rishith-c/Prometheus/pcb/board-3d-top.png

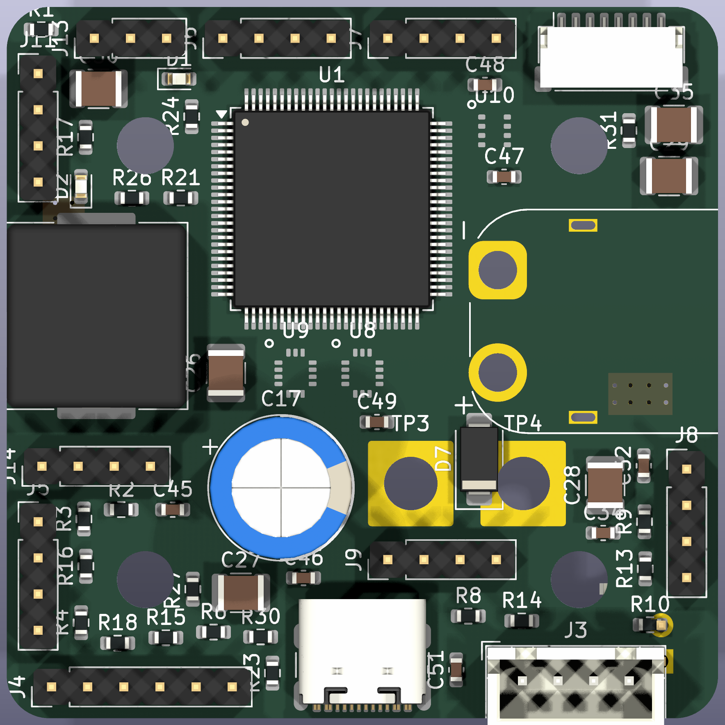
pcb/board-3d-top.png
