rishith-c/Prometheus/pcb/board-3d-angle.png

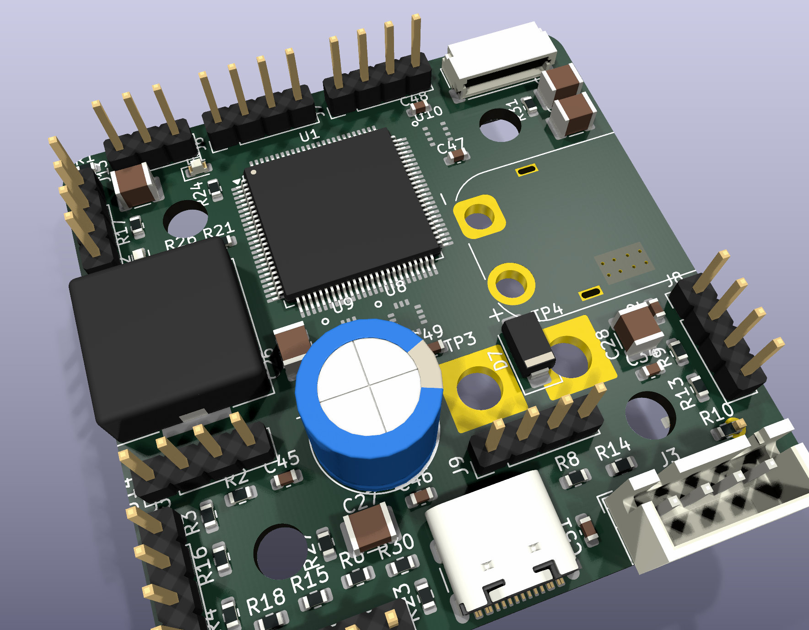
pcb/board-3d-angle.png
