rishith-c/Prometheus/pcb/board-3d-bottom.png

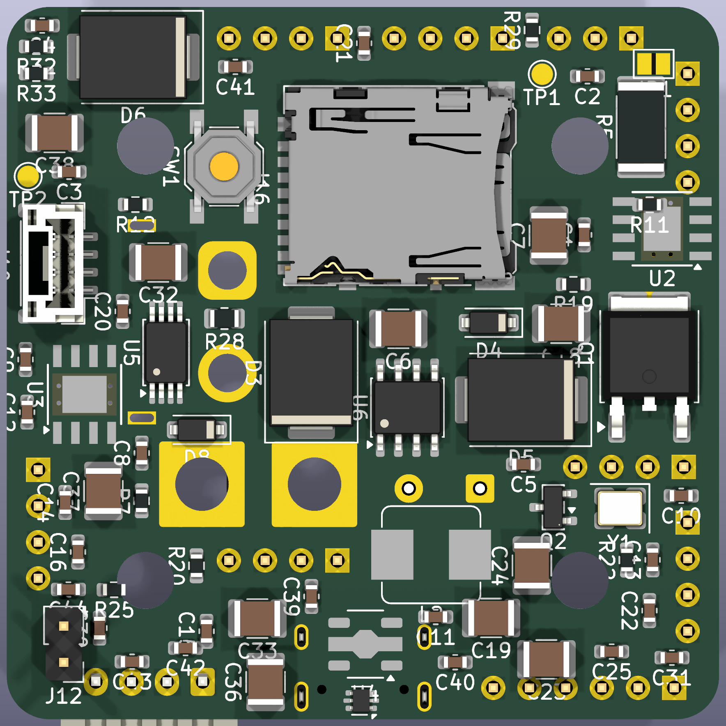
pcb/board-3d-bottom.png
