rishith-c/Prometheus/pcb/baro.kicad_sch

## KiCad design pcb/baro.kicad_sch (2026-07-14)

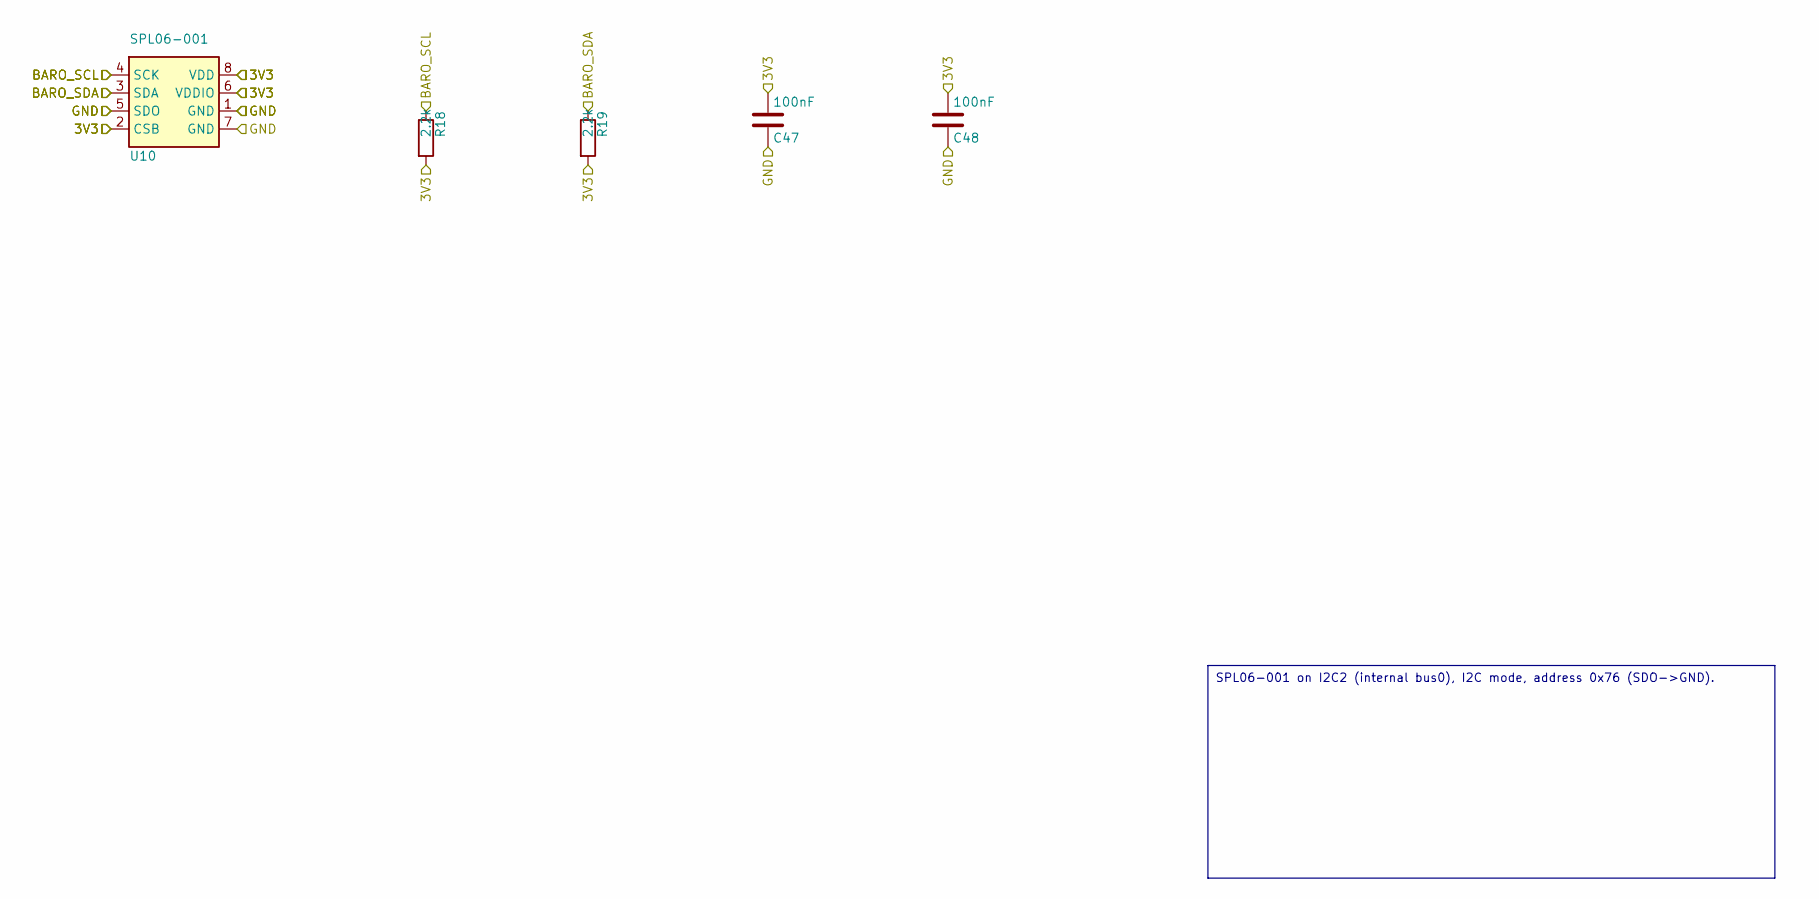
[picture p4: schematic baro.kicad_sch]

Parts:
C47, C48: 100nF; C_0603_1608Metric
R18, R19: 2.2k; R_0603_1608Metric
U10: SPL06-001; SPL06-001_LGA-8_2.0x2.5mm; LCSC C2684428

Connections:
3V3: C47.1, C48.1, R18.2, R19.2, U10.2 (CSB), U10.6 (VDDIO), U10.8 (VDD)
BARO_SCL: R18.1, U10.4 (SCK)
BARO_SDA: R19.1, U10.3 (SDA)
GND: C47.2, C48.2, U10.1 (GND), U10.5 (SDO), U10.7 (GND)

Notes on the sheet:
SPL06-001 on I2C2 (internal bus0), I2C mode, address 0x76 (SDO->GND).
