rishith-c/Prometheus/pcb/bucks_ldo.kicad_sch

## KiCad design pcb/bucks_ldo.kicad_sch (2026-07-14)

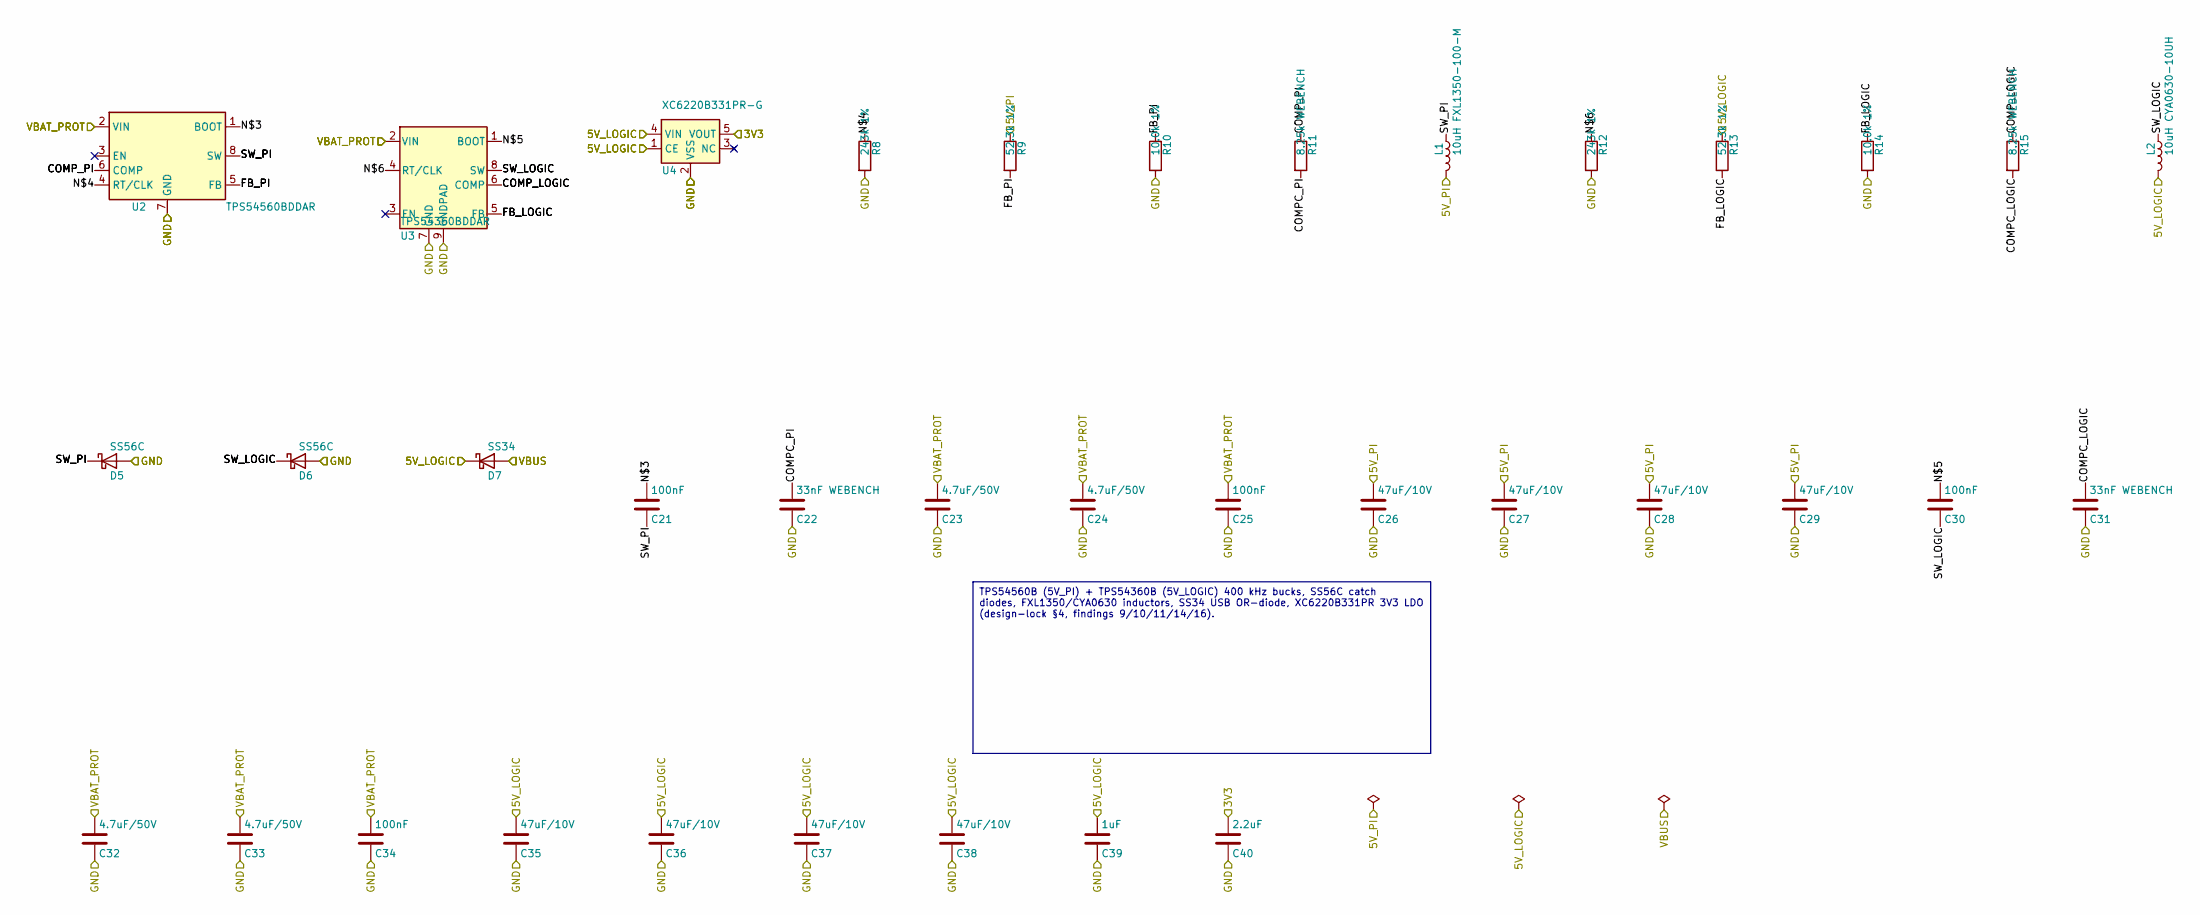
[picture p5: schematic bucks_ldo.kicad_sch]

Parts:
C21, C25, C30, C34: 100nF; C_0603_1608Metric
C22, C31: 33nF WEBENCH; C_0603_1608Metric
C23, C24, C32, C33: 4.7uF/50V; C_1210_3225Metric
C26, C27, C28, C29, C35, C36, C37, C38: 47uF/10V; C_1210_3225Metric
C39: 1uF; C_0603_1608Metric
C40: 2.2uF; C_0603_1608Metric
D5, D6: SS56C; D_SMC; LCSC C24138
D7: SS34; D_SMA; LCSC C8678
L1: 10uH FXL1350-100-M; L_Changjiang_FXL1350; LCSC C526017
L2: 10uH CYA0630-10UH; L_Bourns_SRP7028A_7.3x6.6mm; LCSC C5189958
R8, R12: 243k 1%; R_0603_1608Metric
R9, R13: 52.3k 1%; R_0603_1608Metric
R10, R14: 10.0k 1%; R_0603_1608Metric; LCSC C25804
R11, R15: 8.25k WEBENCH; R_0603_1608Metric
U2: TPS54560BDDAR; TI_SO-PowerPAD-8_ThermalVias; LCSC C1850354
U3: TPS54360BDDAR; TI_SO-PowerPAD-8_ThermalVias; LCSC C524806
U4: XC6220B331PR-G; SOT-89-5; LCSC C3013658

Connections:
3V3: C40.1, U4.5 (VOUT)
5V_LOGIC: C35.1, C36.1, C37.1, C38.1, C39.1, D7.1 (K), L2.2, R13.1, U4.1 (CE), U4.4 (VIN)
5V_PI: C26.1, C27.1, C28.1, C29.1, L1.2, R9.1
COMPC_LOGIC: C31.1, R15.2
COMPC_PI: C22.1, R11.2
COMP_LOGIC: R15.1, U3.6 (COMP)
COMP_PI: R11.1, U2.6 (COMP)
FB_LOGIC: R13.2, R14.1, U3.5 (FB)
FB_PI: R9.2, R10.1, U2.5 (FB)
GND: C22.2, C23.2, C24.2, C25.2, C26.2, C27.2, C28.2, C29.2, C31.2, C32.2, C33.2, C34.2, C35.2, C36.2, C37.2, C38.2, C39.2, C40.2, D5.2 (A), D6.2 (A), R8.2, R10.2, R12.2, R14.2, U2.7 (GND), U2.9 (GND), U3.7 (GND), U3.9 (GNDPAD), U4.2 (VSS)
unnamed: C21.1, U2.1 (BOOT)
unnamed: R8.1, U2.4 (RT/CLK)
unnamed: C30.1, U3.1 (BOOT)
unnamed: R12.1, U3.4 (RT/CLK)
SW_LOGIC: C30.2, D6.1 (K), L2.1, U3.8 (SW)
SW_PI: C21.2, D5.1 (K), L1.1, U2.8 (SW)
VBAT_PROT: C23.1, C24.1, C25.1, C32.1, C33.1, C34.1, U2.2 (VIN), U3.2 (VIN)
VBUS: D7.2 (A)

Notes on the sheet:
TPS54560B (5V_PI) + TPS54360B (5V_LOGIC) 400 kHz bucks, SS56C catch diodes, FXL1350/CYA0630 inductors, SS34 USB OR-diode, XC6220B331PR 3V3 LDO (design-lock §4, findings 9/10/11/14/16).
