rishith-c/Prometheus/pcb/can.kicad_sch

## KiCad design pcb/can.kicad_sch (2026-07-14)

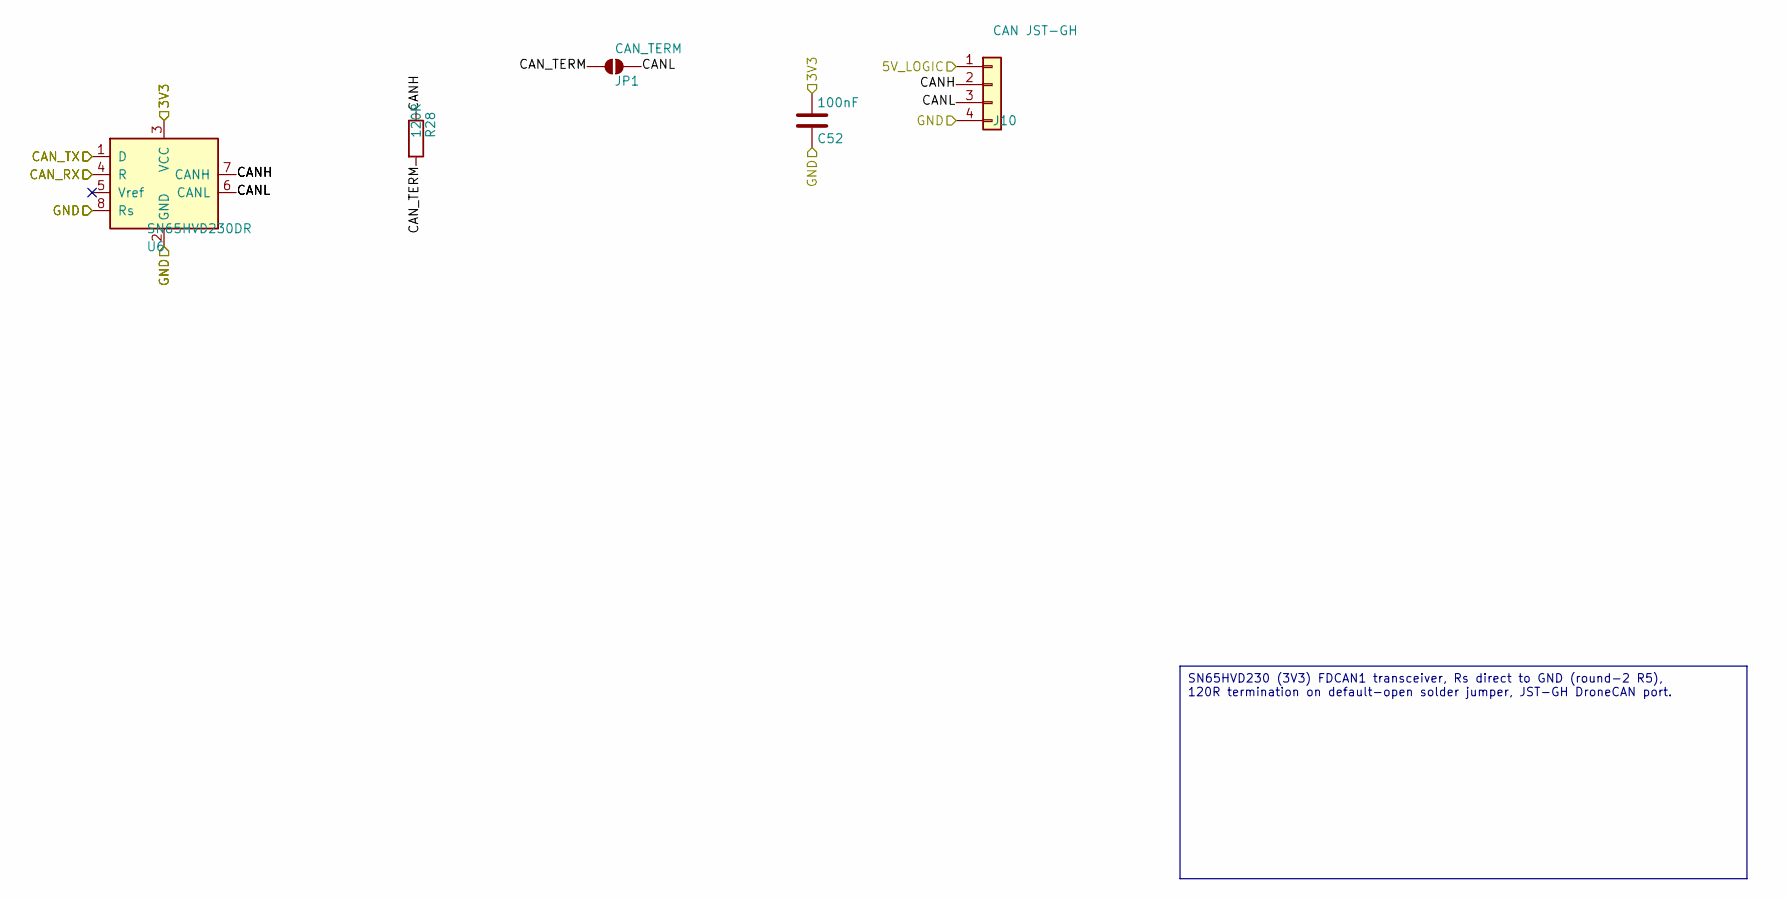
[picture p6: schematic can.kicad_sch]

Parts:
C52: 100nF; C_0603_1608Metric
J10: CAN JST-GH; JST_GH_BM04B-GHS-TBT_1x04-1MP_P1.25mm_Vertical
JP1: CAN_TERM; SolderJumper-2_P1.3mm_Open_Pad1.0x1.5mm
R28: 120R; R_0805_2012Metric
U6: SN65HVD230DR; SOIC-8_3.9x4.9mm_P1.27mm; LCSC C12084

Connections:
3V3: C52.1, U6.3 (VCC)
5V_LOGIC: J10.1
CANH: J10.2, R28.1, U6.7 (CANH)
CANL: J10.3, JP1.2 (B), U6.6 (CANL)
CAN_RX: U6.4 (R)
CAN_TERM: JP1.1 (A), R28.2
CAN_TX: U6.1 (D)
GND: C52.2, J10.4, U6.2 (GND), U6.8 (Rs)

Notes on the sheet:
SN65HVD230 (3V3) FDCAN1 transceiver, Rs direct to GND (round-2 R5), 120R termination on default-open solder jumper, JST-GH DroneCAN port.
