rishith-c/Prometheus/pcb/connectors.kicad_sch

## KiCad design pcb/connectors.kicad_sch (2026-07-14)

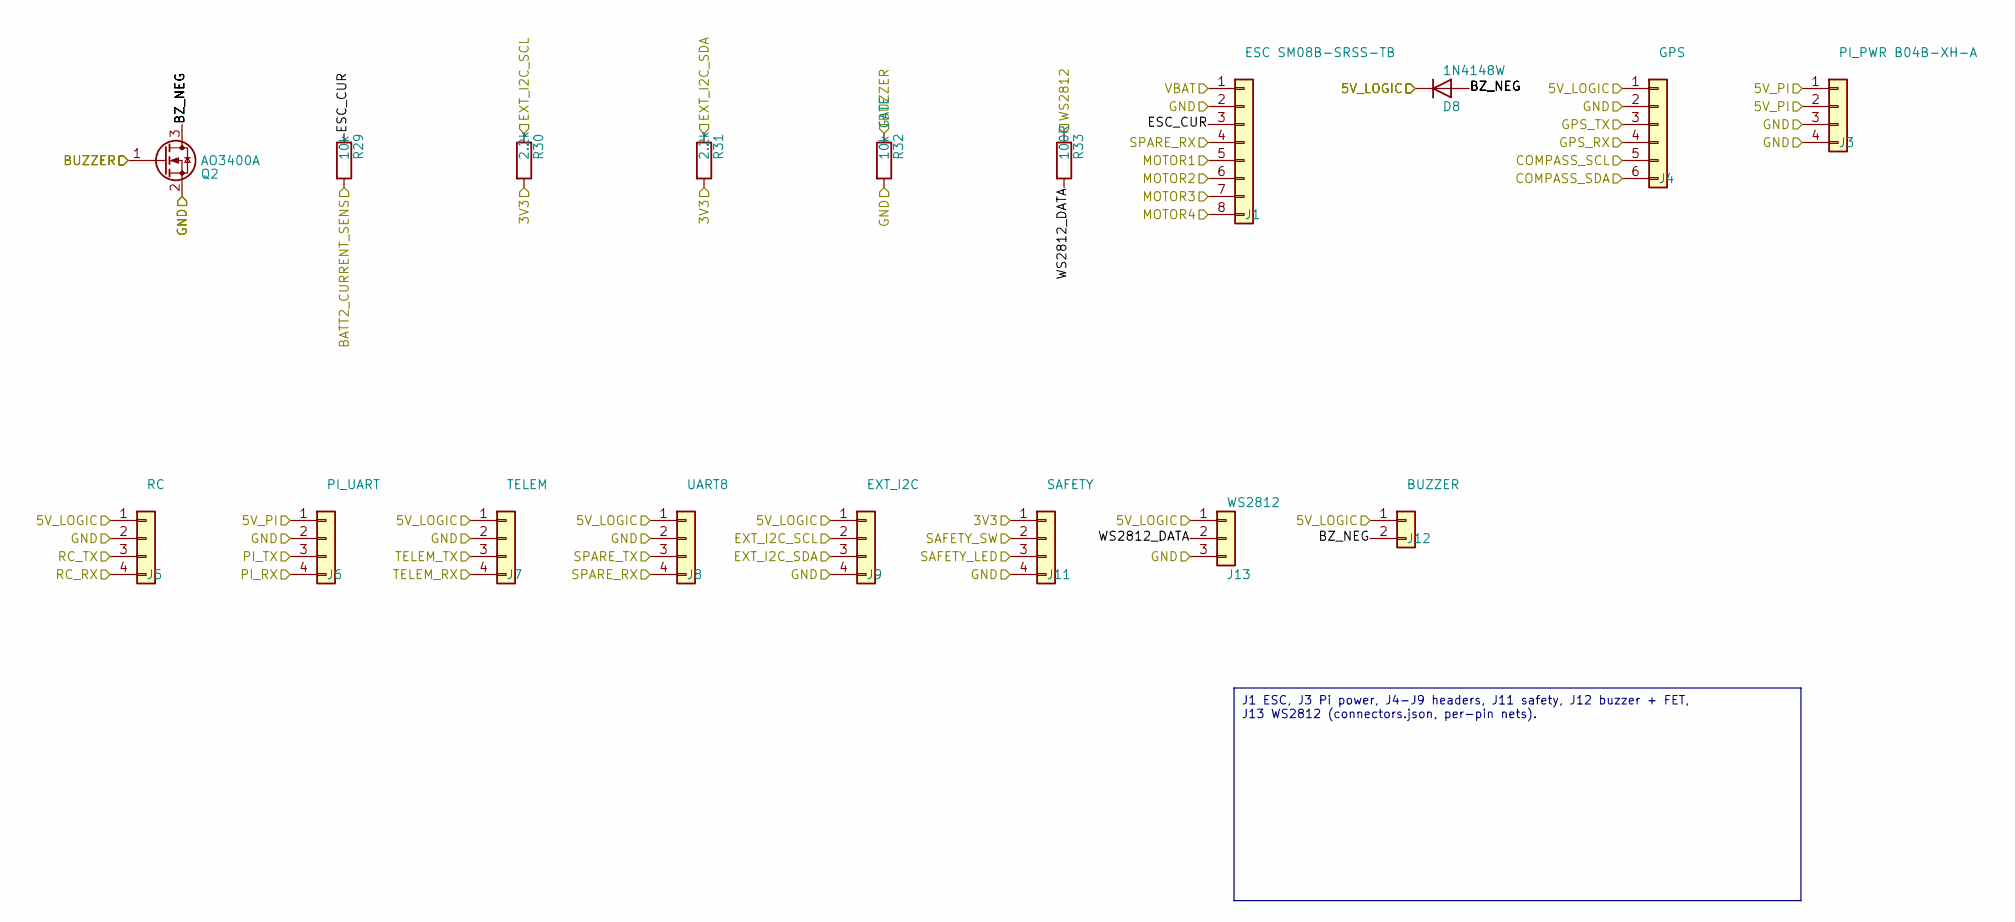
[picture p7: schematic connectors.kicad_sch]

Parts:
D8: 1N4148W; D_SOD-123
J1: ESC SM08B-SRSS-TB; JST_SH_SM08B-SRSS-TB_1x08-1MP_P1.00mm_Horizontal
J3: PI_PWR B04B-XH-A; JST_XH_B4B-XH-A_1x04_P2.50mm_Vertical
J4: GPS; PinHeader_1x06_P2.54mm_Vertical
J5: RC; PinHeader_1x04_P2.54mm_Vertical
J6: PI_UART; PinHeader_1x04_P2.54mm_Vertical
J7: TELEM; PinHeader_1x04_P2.54mm_Vertical
J8: UART8; PinHeader_1x04_P2.54mm_Vertical
J9: EXT_I2C; PinHeader_1x04_P2.54mm_Vertical
J11: SAFETY; PinHeader_1x04_P2.54mm_Vertical
J12: BUZZER; PinHeader_1x02_P2.54mm_Vertical
J13: WS2812; PinHeader_1x03_P2.54mm_Vertical
Q2: AO3400A; SOT-23
R29: 10k; R_0603_1608Metric; LCSC C25804
R30, R31: 2.2k; R_0603_1608Metric
R32: 10k GATE; R_0603_1608Metric; LCSC C25804
R33: 100R; R_0603_1608Metric

Connections:
3V3: J11.1, R30.2, R31.2
5V_LOGIC: D8.1 (K), J4.1, J5.1, J7.1, J8.1, J9.1, J12.1, J13.1
5V_PI: J3.1, J3.2, J6.1
BATT2_CURRENT_SENS: R29.2
BUZZER: Q2.1 (G), R32.1
BZ_NEG: D8.2 (A), J12.2, Q2.3 (D)
COMPASS_SCL: J4.5
COMPASS_SDA: J4.6
ESC_CUR: J1.3, R29.1
EXT_I2C_SCL: J9.2, R30.1
EXT_I2C_SDA: J9.3, R31.1
GND: J1.2, J3.3, J3.4, J4.2, J5.2, J6.2, J7.2, J8.2, J9.4, J11.4, J13.3, Q2.2 (S), R32.2
GPS_RX: J4.4
GPS_TX: J4.3
MOTOR1: J1.5
MOTOR2: J1.6
MOTOR3: J1.7
MOTOR4: J1.8
PI_RX: J6.4
PI_TX: J6.3
RC_RX: J5.4
RC_TX: J5.3
SAFETY_LED: J11.3
SAFETY_SW: J11.2
SPARE_RX: J1.4, J8.4
SPARE_TX: J8.3
TELEM_RX: J7.4
TELEM_TX: J7.3
VBAT: J1.1
WS2812: R33.1
WS2812_DATA: J13.2, R33.2

Notes on the sheet:
J1 ESC, J3 Pi power, J4-J9 headers, J11 safety, J12 buzzer + FET, J13 WS2812 (connectors.json, per-pin nets).
