rishith-c/Prometheus/pcb/imu.kicad_sch

## KiCad design pcb/imu.kicad_sch (2026-07-14)

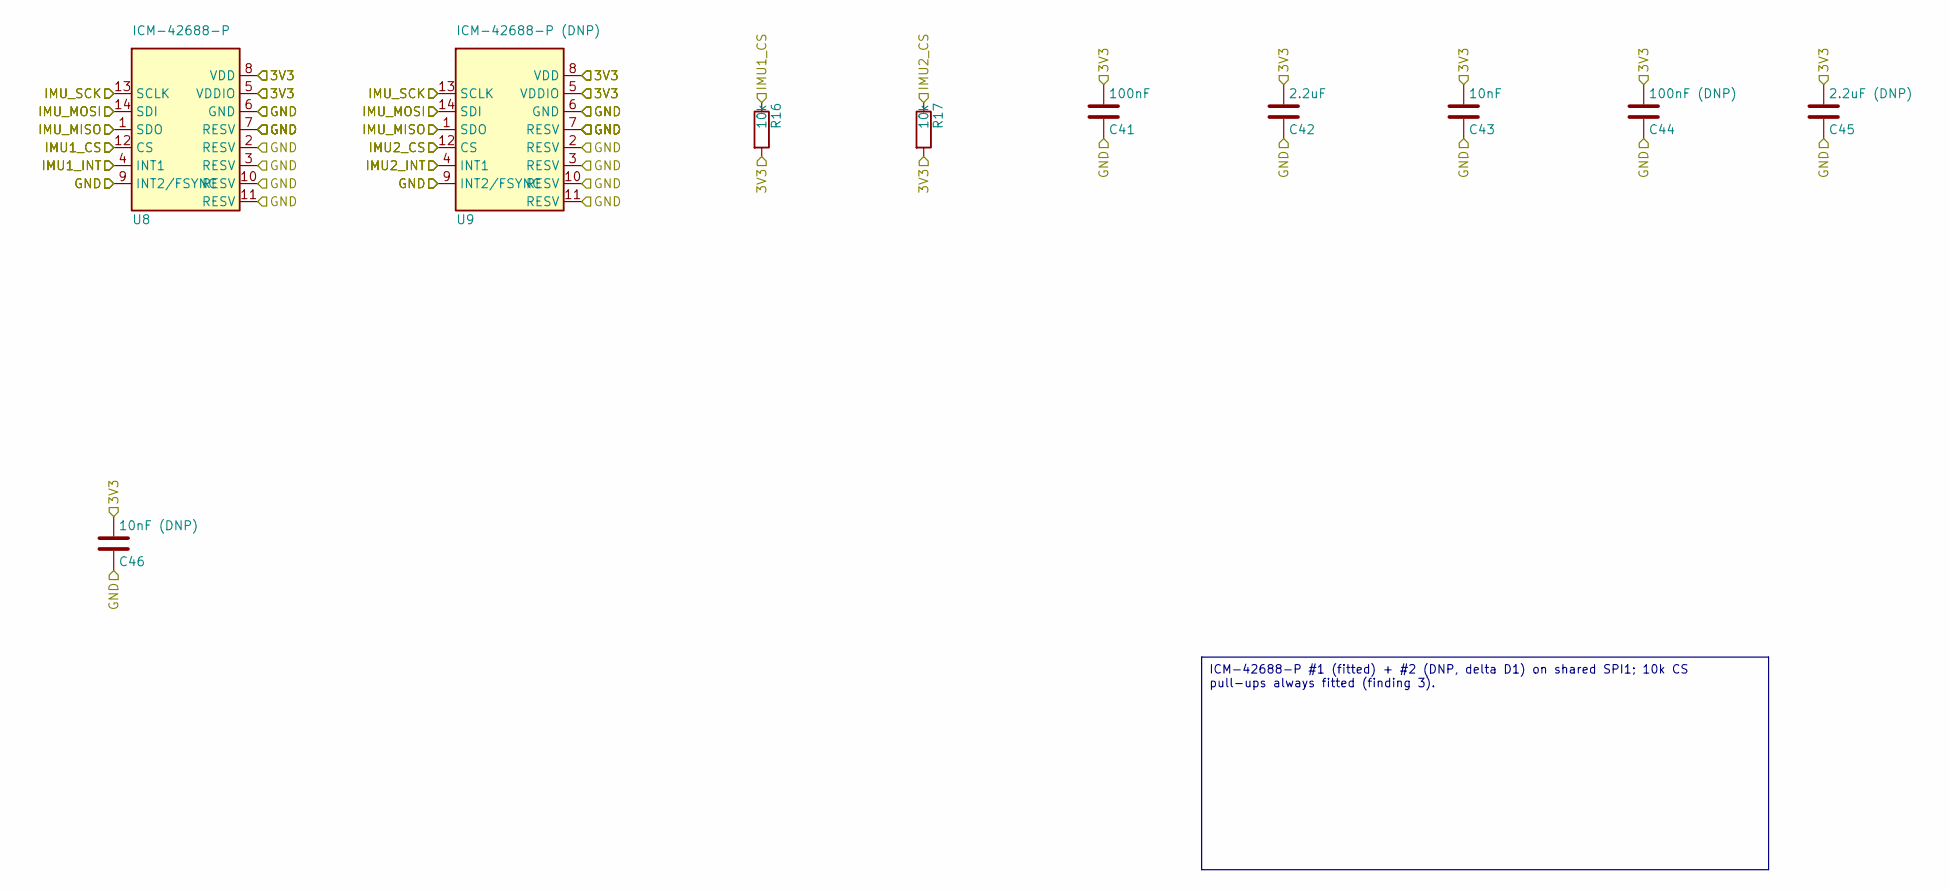
[picture p8: schematic imu.kicad_sch]

Parts:
C41: 100nF; C_0603_1608Metric
C42: 2.2uF; C_0603_1608Metric
C43: 10nF; C_0603_1608Metric
C44: 100nF (DNP); C_0603_1608Metric
C45: 2.2uF (DNP); C_0603_1608Metric
C46: 10nF (DNP); C_0603_1608Metric
R16, R17: 10k; R_0603_1608Metric; LCSC C25804
U8: ICM-42688-P; ICM-42688-P_LGA-14_2.5x3mm_P0.5mm; LCSC C1850418
U9: ICM-42688-P (DNP); ICM-42688-P_LGA-14_2.5x3mm_P0.5mm

Connections:
3V3: C41.1, C42.1, C43.1, C44.1, C45.1, C46.1, R16.2, R17.2, U8.5 (VDDIO), U8.8 (VDD), U9.5 (VDDIO), U9.8 (VDD)
GND: C41.2, C42.2, C43.2, C44.2, C45.2, C46.2, U8.2 (RESV), U8.3 (RESV), U8.6 (GND), U8.7 (RESV), U8.9 (INT2/FSYNC), U8.10 (RESV), U8.11 (RESV), U9.2 (RESV), U9.3 (RESV), U9.6 (GND), U9.7 (RESV), U9.9 (INT2/FSYNC), U9.10 (RESV), U9.11 (RESV)
IMU1_CS: R16.1, U8.12 (CS)
IMU1_INT: U8.4 (INT1)
IMU2_CS: R17.1, U9.12 (CS)
IMU2_INT: U9.4 (INT1)
IMU_MISO: U8.1 (SDO), U9.1 (SDO)
IMU_MOSI: U8.14 (SDI), U9.14 (SDI)
IMU_SCK: U8.13 (SCLK), U9.13 (SCLK)

Notes on the sheet:
ICM-42688-P #1 (fitted) + #2 (DNP, delta D1) on shared SPI1; 10k CS pull-ups always fitted (finding 3).
