rishith-c/Prometheus/pcb/microsd.kicad_sch

## KiCad design pcb/microsd.kicad_sch (2026-07-14)

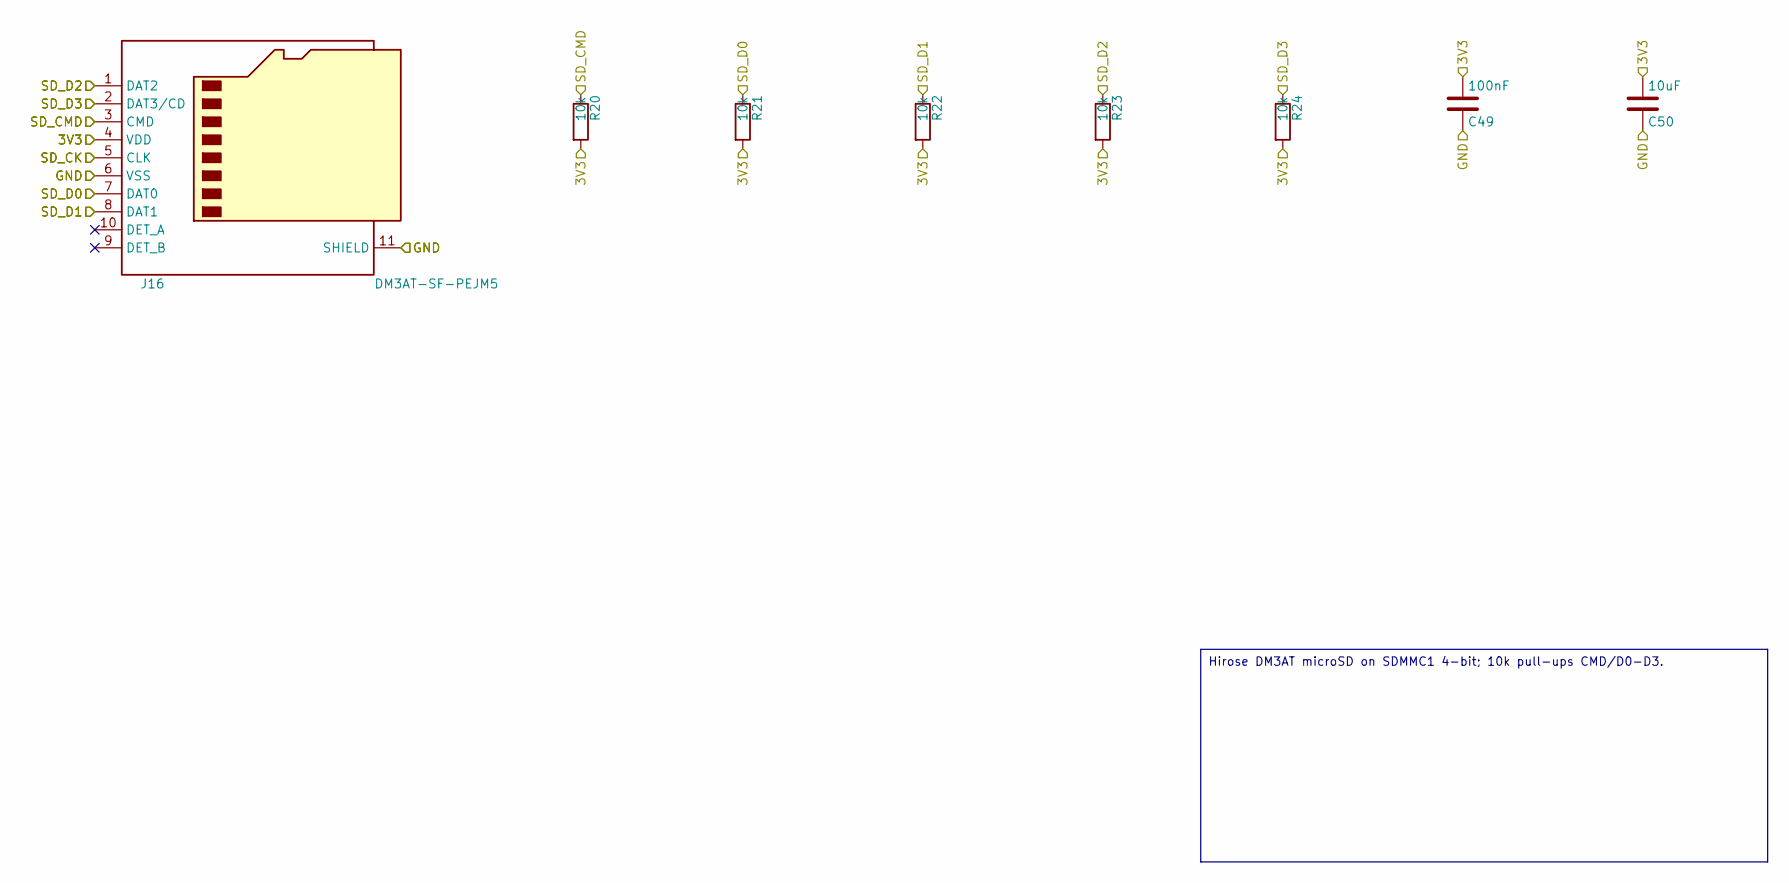
[picture p9: schematic microsd.kicad_sch]

Parts:
C49: 100nF; C_0603_1608Metric
C50: 10uF; C_1210_3225Metric
J16: DM3AT-SF-PEJM5; microSD_HC_Hirose_DM3AT-SF-PEJM5
R20, R21, R22, R23, R24: 10k; R_0603_1608Metric; LCSC C25804

Connections:
3V3: C49.1, C50.1, J16.4 (VDD), R20.2, R21.2, R22.2, R23.2, R24.2
GND: C49.2, C50.2, J16.6 (VSS), J16.11 (SHIELD)
SD_CK: J16.5 (CLK)
SD_CMD: J16.3 (CMD), R20.1
SD_D0: J16.7 (DAT0), R21.1
SD_D1: J16.8 (DAT1), R22.1
SD_D2: J16.1 (DAT2), R23.1
SD_D3: J16.2 (DAT3/CD), R24.1

Notes on the sheet:
Hirose DM3AT microSD on SDMMC1 4-bit; 10k pull-ups CMD/D0-D3.
