rishith-c/Prometheus/pcb/power_input.kicad_sch

## KiCad design pcb/power_input.kicad_sch (2026-07-14)

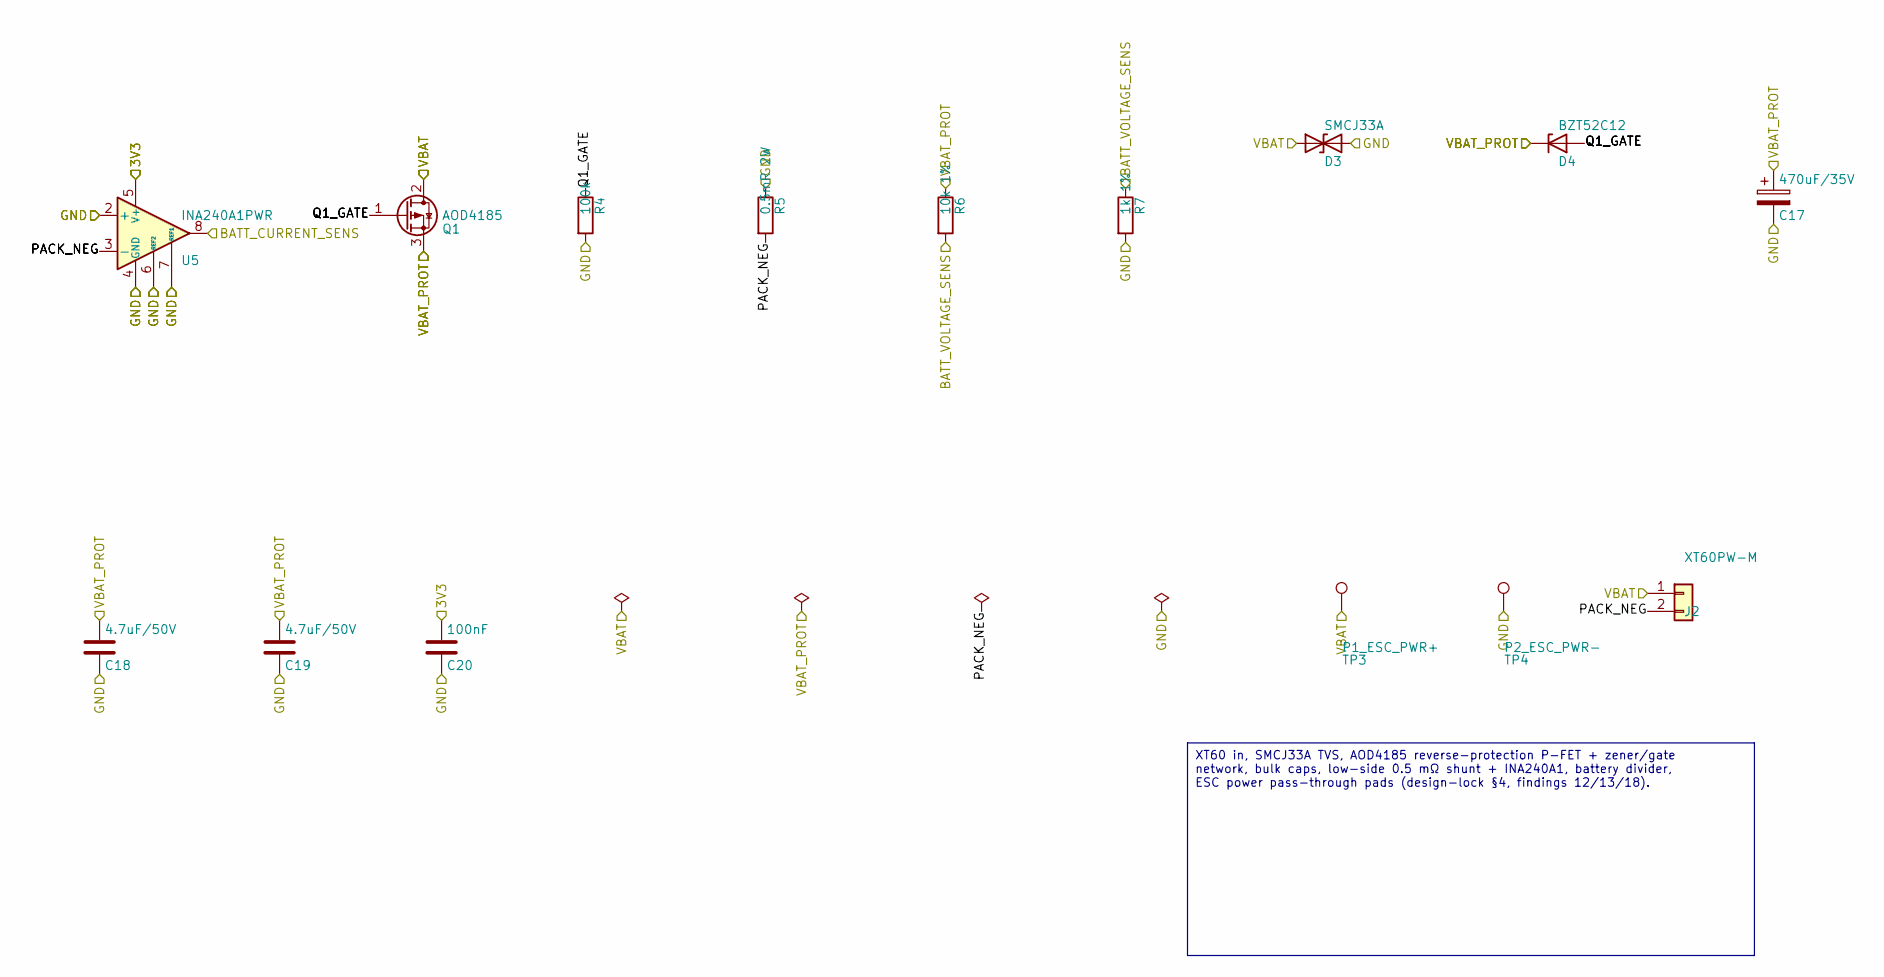
[picture p10: schematic power_input.kicad_sch]

Parts:
C17: 470uF/35V; CP_Radial_D10.0mm_P5.00mm; LCSC C136284
C18, C19: 4.7uF/50V; C_1210_3225Metric
C20: 100nF; C_0603_1608Metric
D3: SMCJ33A; D_SMC; LCSC verify-at-order
D4: BZT52C12; D_SOD-123; LCSC verify-at-order
J2: XT60PW-M; AMASS_XT60PW-M_1x02_P7.20mm_Horizontal
Q1: AOD4185; TO-252-2; LCSC C400894
R4: 100k; R_0603_1608Metric
R5: 0.5mR 2W; R_2512_6332Metric; LCSC C500611
R6: 10k 1%; R_0603_1608Metric; LCSC C25804
R7: 1k 1%; R_0603_1608Metric; LCSC C21190
TP3: P1_ESC_PWR+; SolderWire-4sqmm_1x01_D3mm_OD6mm
TP4: P2_ESC_PWR-; SolderWire-4sqmm_1x01_D3mm_OD6mm
U5: INA240A1PWR; TSSOP-8_4.4x3mm_P0.65mm; LCSC C93965

Connections:
3V3: C20.1, U5.5 (V+)
BATT_CURRENT_SENS: U5.8
BATT_VOLTAGE_SENS: R6.2, R7.1
GND: C17.2, C18.2, C19.2, C20.2, D3.2 (A2), R4.2, R5.1, R7.2, TP4.1, U5.1 (GND), U5.2 (+), U5.4 (GND), U5.6 (REF2), U5.7 (REF1)
PACK_NEG: J2.2, R5.2, U5.3 (-)
Q1_GATE: D4.2 (A), Q1.1 (G), R4.1
VBAT: D3.1 (A1), J2.1, Q1.2 (D), TP3.1
VBAT_PROT: C17.1, C18.1, C19.1, D4.1 (K), Q1.3 (S), R6.1

Notes on the sheet:
XT60 in, SMCJ33A TVS, AOD4185 reverse-protection P-FET + zener/gate network, bulk caps, low-side 0.5 mΩ shunt + INA240A1, battery divider, ESC power pass-through pads (design-lock §4, findings 12/13/18).
