rishith-c/Prometheus/pcb/usb_c.kicad_sch

## KiCad design pcb/usb_c.kicad_sch (2026-07-14)

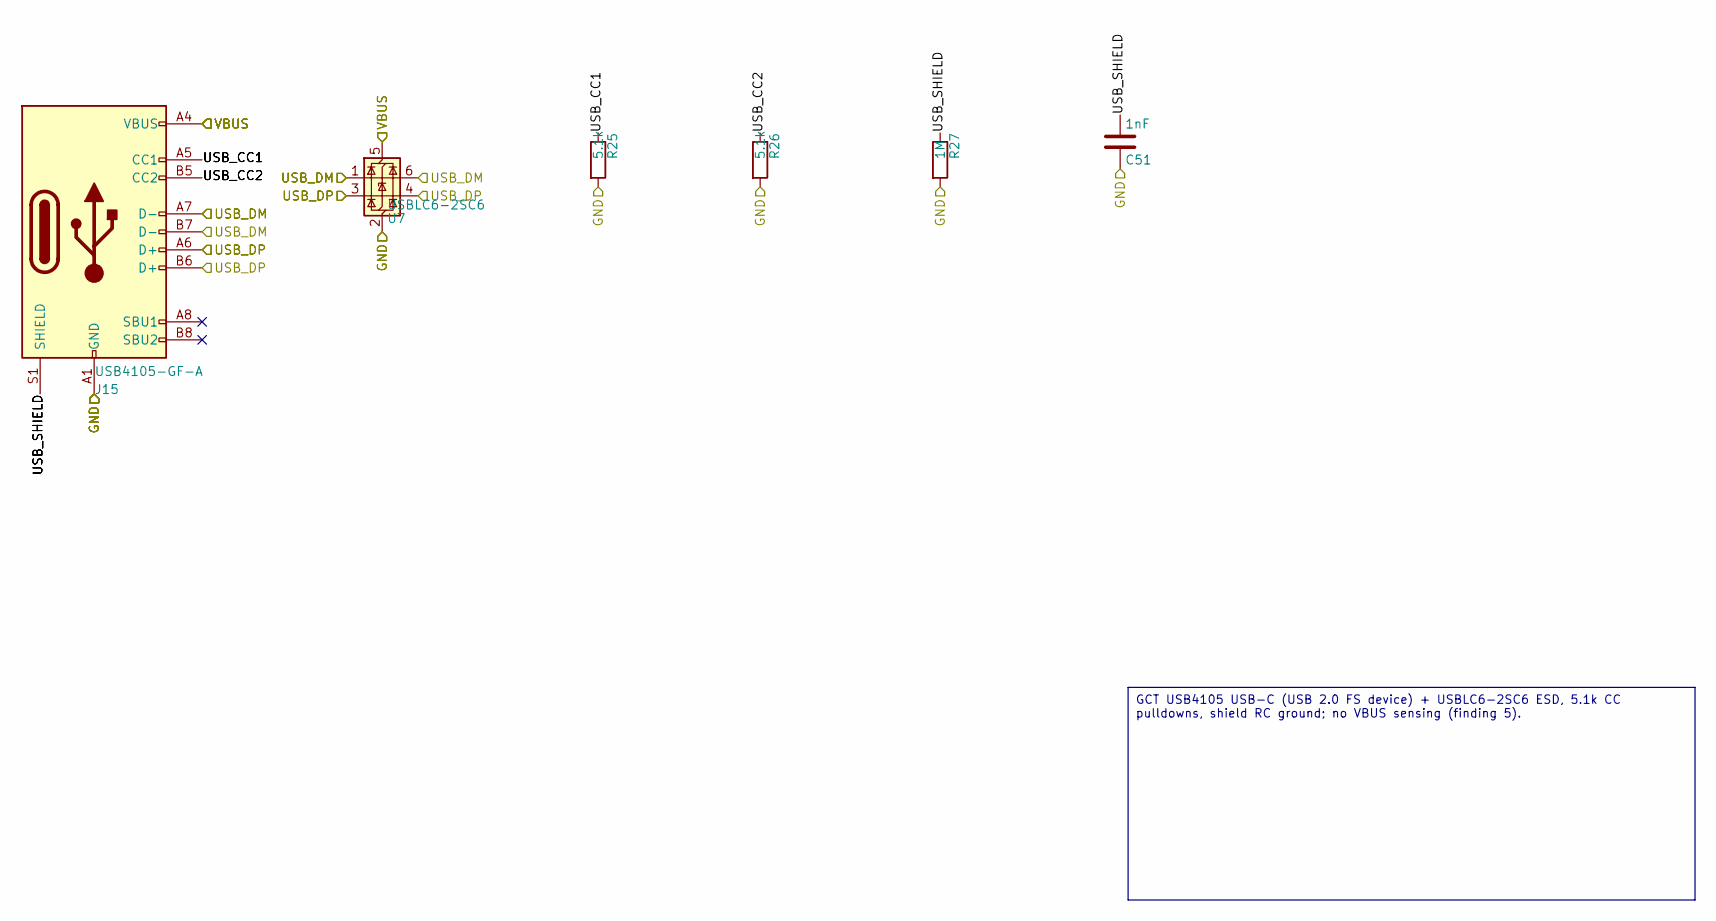
[picture p11: schematic usb_c.kicad_sch]

Parts:
C51: 1nF; C_0603_1608Metric
J15: USB4105-GF-A; USB_C_Receptacle_GCT_USB4105-xx-A_16P_TopMnt_Horizontal; LCSC C2988369
R25, R26: 5.1k; R_0603_1608Metric
R27: 1M; R_0603_1608Metric
U7: USBLC6-2SC6; SOT-666; LCSC C7519

Connections:
GND: C51.2, J15.A1 (GND), J15.A12 (GND), J15.B1 (GND), J15.B12 (GND), R25.2, R26.2, R27.2, U7.2 (GND)
USB_CC1: J15.A5 (CC1), R25.1
USB_CC2: J15.B5 (CC2), R26.1
USB_DM: J15.A7 (D-), J15.B7 (D-), U7.1 (I/O1), U7.6 (I/O1)
USB_DP: J15.A6 (D+), J15.B6 (D+), U7.3 (I/O2), U7.4 (I/O2)
USB_SHIELD: C51.1, J15.S1 (SHIELD), R27.1
VBUS: J15.A4 (VBUS), J15.A9 (VBUS), J15.B4 (VBUS), J15.B9 (VBUS), U7.5 (VBUS)

Notes on the sheet:
GCT USB4105 USB-C (USB 2.0 FS device) + USBLC6-2SC6 ESD, 5.1k CC pulldowns, shield RC ground; no VBUS sensing (finding 5).
