rishith-c/Prometheus/(commit log)

2026-06-27 Added BOM.csv
    :()
    [BOM.csv]
2026-06-27 Added BOM.csv
    [BOM.csv]
2026-06-27 Add BOM.csv
    [BOM.csv]
2026-06-27 pls speed make this the final one
    [BOM.csv]
2026-07-13 Update BOM for qualification hexacopter
    [BOM.csv]
2026-07-13 Expand BOM for autonomous fire response hexacopter
    [BOM.csv]
